ahmednossierr/Zigbee-Transmitter/Scripts/Our_scripts/imag_test.txt

000000
111111
111011
000000
010000
001010
101101
100011
111101
011010
011011
000011
101000
100001
110000
001001
011011
011110
010010
000000
101110
100011
100001
100101
101110
111000
000010
001011
010001
010110
011001
011010
011000
010100
001110
001000
000011
000000
000000
000000
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
