ahmednossierr/Zigbee-Transmitter/ITI_project2026.pdf

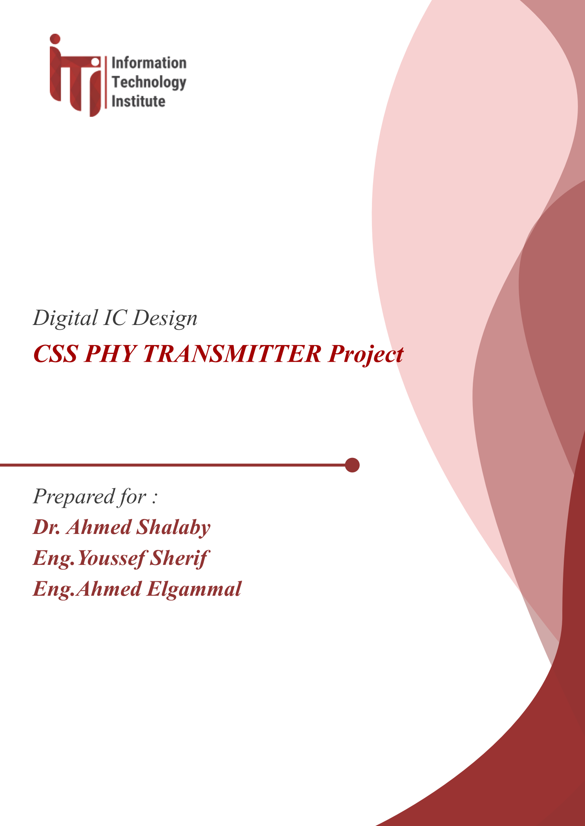
[picture p1: figure]
Digital IC Design; CSS PHY TRANSMITTER Project; Prepared for :; Dr. Ahmed Shalaby; Eng.Youssef Sherif; Eng.Ahmed Elgammal

Digital IC Design CSS_PHY_TRANSMITTER Project – Report

2

## Table of Contents

3

4

## Abstract

This project presents the design and RTL implementation of an IEEE 802.15.4 Chirp Spread Spectrum (CSS) Physical Layer transmitter. The transmitter receives a payload from the MAC layer and processes it through the required PHY operations, including zero padding, I/Q demultiplexing, symbol mapping, QPSK mapping, DQPSK coding, and CSS chirp generation. The design is implemented using Verilog HDL and verified through simulation using ModelSim. The objective is to develop a modular digital transmitter architecture that follows the processing requirements of the CSS PHY.

5

## Chapter1 – Introduction

## 1.1 Motivation

Low-rate wireless personal area networks (LR-WPANs) require low cost, low power, and long battery life. IEEE 802.15.4 defines the MAC and PHY layers for this purpose, including the Chirp Spread Spectrum (CSS) PHY at 2450 MHz. CSS offers strong robustness to multipath fading and interference, and supports longer range and mobility compared to the standard's O-QPSK PHY, but it is significantly more complex to implement in hardware due to its chirp-based modulation and differential coding.

## 1.2 Problem Statement and Objectives

A floating-point MATLAB model of the CSS PHY transmitter already existed, implementing the processing chain defined in the standard. This work converts that model into working hardware: a fixed-point representation is derived, a Verilog RTL implementation is designed module by module, the RTL is verified against the MATLAB model at both unit and integration level, and the design is implemented and verified on a Xilinx Spartan-3A FPGA.

## 1.3 Scope

This work covers the CSS PHY transmitter only; the receiver and MAC integration are left as future work. The existing MATLAB model is used solely as a verification reference, not developed as part of this work.

## 1.4 GitHub Link (https://github.com/ahmednossierr/Zigbee-Transmitter)

That GitHub Link have all the codes and testbenches and constraints files needed for this Zigbee transmitter project.

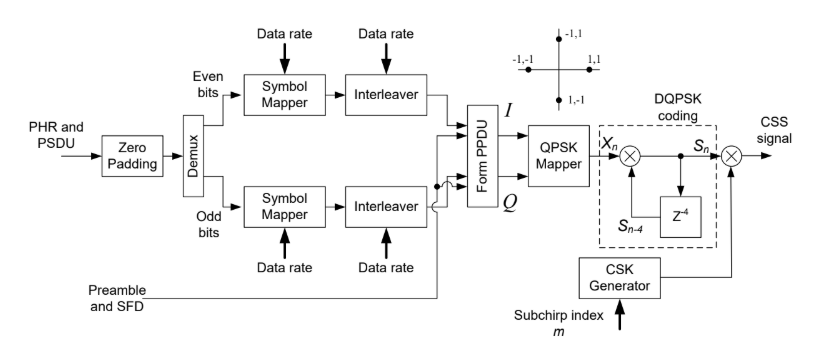
[picture p2: figure]

6

## Chapter 2 —System Architecture & Technical Specifications

## 2.1 IEEE 802.15.4 CSS PPDU Frame Structure

The Physical Protocol Data Unit (PPDU) for the IEEE 802.15.4 Chirp Spread Spectrum (CSS) physical layer consists of three main components: the Synchronization Header (SHR), the PHY Header (PHR), and the PHY Service Data Unit (PSDU) payload.
1. Synchronization Header (SHR): Contains the Preamble sequence and the Start-of-Frame Delimiter (SFD). These allow the receiver to perform bit sync, frame boundary detection, and channel estimation.
2.PHY Header (PHR): Encodes critical packet parameters, including the total length of the payload in bytes (up to 127 bytes).
3.PHY Service Data Unit (PSDU): The actual payload data stream transferred from the MAC layer to the PHY layer.

Figure 1: Format of the CSS PPDU

## 2.2 Transmitter Processing Pipeline

The CSS physical layer transmitter processes the input data bit stream sequentially through multiple digital

Figure 2: Transmitter Pipeline

7

processing blocks before outputting quadrature baseband signal samples.

### 2.2.1 Zero-Padding & Demux (I/Q Splitter)

Zero-Padding: Ensures that the bit stream comprising the PHR and PSDU is padded with trailing zeros so that its total length becomes a integer multiple of N (N = 24 for 250 kbps).
Demux: The serial padded bit stream is split into alternating even bits (in-phase I-channel) and odd bits (quadrature Q-channel).

### 2.2.2 Symbol Mapper (Walsh–Hadamard Encoding)

To enhance immunity against noise and interference, incoming groups of n bits are block-encoded into m-bit orthogonal Walsh–Hadamard codewords using predefined standard look-up tables (Tables 26a/26b of the IEEE 802.15.4 standard). .
For 250 kbps operation, n = 6 input bits map to m = 32 codeword bits.

### 2.2.3 Interleaver

Operating exclusively in 250 kbps mode , the interleaver permutes groups of encoded bits to disperse burst errors. It reorders 16 groups of 4 bits each according to a fixed permutation matrix.

### 2.2.4 PPDU Framer & Controller

The controller coordinates the sequential assembly of the PPDU frame.
It inserts the static preamble and SFD patterns ahead of the PHR and encoded payload data streams before passing them down the datapath.

### 2.2.5 QPSK Mapper & Differential QPSK (DQPSK) Encoder

QPSK Mapper: Grouped pairs of (I,Q) bits are mapped onto standard QPSK constellation points.

DQPSK Encoder: To provide non-coherent phase modulation, each QPSK symbol is differentially encoded across 4 symbol periods:
Sn = Xn ⋅ Sn−4
where Sn represents the complex differential symbol, Xn is the current QPSK symbol, and S0 = S1 = S2 = S3 = exp(jπ/4) serve as the initialization vector.

### 2.2.6 Chirp Spread Keying (CSK) Generator & Modulator

The primary DSP element of the transmitter: four successive DQPSK symbols select one of four possible 152-sample Chirp Sequences (m ∈ {1,2,3,4}).
Each chirp sequence is constructed from four 38-sample sinusoidal subchirps at a sampling frequency fs = 32 MHz, shaped by a raised-cosine window (roll-off factor α = 0.25).
The complex product of the DQPSK symbol sequence and the baseband Chirp Sequence yields the final complex output samples.

8

## 2.3 System Interface & Pinout Description

The top-level synthesizable Verilog module exposes a standardized interface designed for seamless integration with a MAC controller and system memory.

Signal name | Bit width | Direction | Type
clk | 1 | Input | Clock
reset | 1 | Input | Reset
Start_Tx | 1 | Input | Control
payloadlength | 8 | Input | Data
Payload_din | 8 | Input | Data
Payload_addr | 7 | Input | Address
done_tx | 1 | Output | Control
Tx_real | 8 | Output | Data
Tx_imag | 8 | Output | data

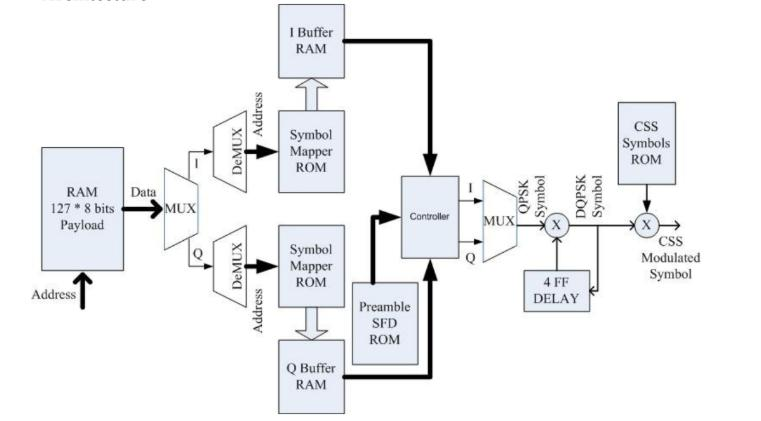
[picture p3: figure]

9

## Chapter 3: Verilog Hardware Design & Implementation

## 3.1 Top-Level Architecture & Datapath Strategy

The CSS PHY transmitter is implemented using a modular top-down architecture, separating control and datapath logic. The top-level module (css_phy_tx) orchestrates the pipeline stages through a centralized Finite State Machine (FSM), controlling signal flow from the initial payload configuration to the final baseband sample output.

## 3.2 Sub-Module Microarchitecture & Signal Interfaces

3.2.1 Payload RAM (ram.v) (https://drive.google.com/file/d/1fCMLNvzGDd0mUedqAVc2X7HKAnIe1TxN/view?usp=drive_link)

Microarchitecture & Logic: Implements a single-clock dual-port RAM storing up to 127 bytes (127 × 8 bits) of incoming MAC payload data. Data is written via din on assertion of write_enable and read out through dout. A generate block continuously exposes the internal memory array as a concatenated 1016-bit vector (psdu_out) to facilitate parallel frame assembly downstream.

Signal Name | Bit Width | Direction | Type | Description
clk | 1 | Input | Clock | System clock signal.
reset | 1 | Input | Reset | Synchronous reset signal.
write_enable | 1 | Input | Control | Write enable strobe for loading payload bytes.
read_enable | 1 | Input | Control | Read enable strobe for reading byte output.

Figure 3: Transmitter Architecture

10

Signal Name | Bit Width | Direction | Type | Description
addr | 7 | Input | Address | RAM byte address pointer (0 to 126).
din | 8 | Input | Data | Input data byte bus.
dout | 8 | Output | Data | Registered output data byte bus.
psdu_out | 1016 | Output | Data | Parallel 1016-bit concatenated payload bitstream bus.

3.2.2 Zero-Padding Unit (zero_padding.v) (https://drive.google.com/file/d/1PPshwE1iD-Davc_w41ABcBWzSWLXKv-_/view?usp=sharing)

Microarchitecture & Logic: Prepends the 12-bit PHY Header (PHR) constructed from payload_length ahead of PSDU. It calculates required trailing zero-padding bits dynamically based on configured Data_Rate (250 kbps) to ensure total frame length is aligned to N-bit boundaries (N = 24). It outputs the serial frame bit by bit along with a complete padded_data vector.

Signal Name | Bit Width | Direction | Type | Description
clk | 1 | Input | Clock | System clock signal
reset | 1 | Input | Reset | Synchronous reset signal
start_tx | 1 | Input | Control | Frame transmission trigger pulse
payload_length | 8 | Input | Data | Total payload length in bytes
PSDU | 1016 | Input | Data | 1016-bit full payload stream from Payload RAM
out_bit | 1 | Output | Data | Serial output bit stream
valid_out | 1 | Output | Control | Active-high output valid indicator
padding_done | 1 | Output | Control | Pulses high when total frame construction completes
padded_data | 1032 | Output | Data | Complete framed and zero-padded bitstream array
total_bits | 11 | Output | Data | Calculated bit length of framed packet

11

### 3.2.3 Demultiplexer Unit (demux.v)

Microarchitecture & Logic: Splits the continuous padded_data stream into parallel in-phase (in_phase, even bits) and quadrature (quadrature, odd bits) streams. A running control flag tracks processing state and increments bit indices by 2 each clock cycle until total_bits - 2 is reached.

Signal Name | Bit Width | Direction | Type | Description
clk | 1 | Input | Clock | System clock signal
reset | 1 | Input | Reset | Synchronous reset signal
start_demux | 1 | Input | Control | Demux processing trigger pulse
padded_data | 1032 | Input | Data | Zero-padded input frame array
total_bits | 11 | Input | Data | Total bit count of frame
in_phase | 1 | Output | Data | Even-indexed bit stream (I-path)
quadrature | 1 | Output | Data | Odd-indexed bit stream (Q-path)
valid_out | 1 | Output | Control | High when output I/Q bits are valid

### 3.2.4 Symbol Mapper (symbol_mapper.v)

Microarchitecture & Logic: Stores the normative IEEE 802.15.4 Walsh–Hadamard orthogonal code table inside a 64-entry 32-bit ROM lookup array . Maps 6-bit incoming symbol indices (data_in) to corresponding 32-bit orthogonal codewords (data_out) with a 1-cycle registered latency.

Signal Name | Bit Width | Direction | Type | Description
clk | 1 | Input | Clock | System clock signal
reset | 1 | Input | Reset | Synchronous reset signal
valid_in | 1 | Input | Control | Active-high input valid strobe
data_in | 6 | Input | Data | 6-bit input symbol vector
data_out | 32 | Output | Data | 32-bit mapped Walsh–Hadamard codeword
valid_out | 1 | Output | Control | Synchronized output valid indicator

12

### 3.2.5 Symbol Buffer (symbol_buffer.v)

Microarchitecture & Logic: Pairs and concatenates successive 32-bit codewords into 64-bit blocks[ci. Uses an internal toggling flag to register the first (even) 32-bit codeword and combine it with the second (odd) incoming 32-bit codeword to drive intrlv_data alongside an intrlv_valid.

Signal Name | Bit Width | Direction | Type | Description
clk | 1 | Input | Clock | System clock signal
reset | 1 | Input | Reset | Synchronous reset signal
sym_valid | 1 | Input | Control | Valid pulse from Symbol Mapper
sym_data | 32 | Input | Data | 32-bit codeword from Symbol Mapper
intrlv_valid | 1 | Output | Control | High when concatenated 64-bit block is ready
intrlv_data | 64 | Output | Data | 64-bit concatenated output block

### 3.2.6 Interleaver Unit (interleaver.v)

Microarchitecture & Logic: Implements the static 250 kbps permutation matrix using a fully combinational Verilog generate loop. Reorders 16 4-bit nibble groups of the incoming 64-bit block (block_in) to yield the permuted output block (block_out) with zero clock delay.

Signal Name | Bit Width | Direction | Type | Description
block_in | 64 | Input | Data | Un-interleaved 64-bit input block
block_out | 64 | Output | Data | Permuted 64-bit output block

### 3.2.7 PPDU Framer & Controller (PPDU.v)

Microarchitecture & Logic: Coordinates PPDU assembly using an internal state machine (IDLE, PREAMBLE, SFD, WAIT, SEND, DONE_STATETransmits an 80-symbol Preamble and 16-symbol SFD pattern from ROM before reading symbol blocks out of an integrated 8-entry 64-bit FIFO (fifo_i, fifo_q) and shifting them out bit by bit.

13

Signal Name | Bit Width | Direction | Type | Description
clk | 1 | Input | Clock | System clock signal
reset | 1 | Input | Reset | Synchronous system reset
start | 1 | Input | Control | Transmission trigger signal
total_bits | 11 | Input | Data | Frame length parameter from Zero-Padding unit
i_path_data | 64 | Input | Data | In-phase 64-bit data block
q_path_data | 64 | Input | Data | Quadrature 64-bit data block
i_path_valid | 1 | Input | Control | Valid indicator for I-path input
q_path_valid | 1 | Input | Control | Valid indicator for Q-path input
ppdu_i_out | 1 | Output | Data | Serial I-path PPDU bit stream
ppdu_q_out | 1 | Output | Data | Serial Q-path PPDU bit stream
ppdu_valid | 1 | Output | Control | High during valid frame bit streaming
done | 1 | Output | Control | Pulse high on packet completion

### 3.2.8 QPSK Mapper (qpsk_mapper.v)

- Microarchitecture & Logic: Maps 2-bit (I,Q) pairs to signed fixed-point QPSK constellation coordinates.Maps input bits {inphase, quadrature} to signed values Xn ∈ {−1,0,1} represented in 2'sd format.
Signal Name | Bit Width | Direction | Type | Description
clk | 1 | Input | Clock | System clock signal[cite: 6].
reset | 1 | Input | Reset | Synchronous reset signal[cite: 6].
inphase | 1 | Input | Data | Incoming I-channel bit[cite: 6].
quadrature | 1 | Input | Data | Incoming Q-channel bit[cite: 6].
valid_in | 1 | Input | Control | Valid signal from PPDU Framer[cite: 6].

14

### 3.2.9 Differential QPSK (DQPSK) Encoder (dqpsk.v)

Microarchitecture & Logic: Converts input rectangular QPSK symbols into 8-phase values (in_phase ∈ {0,2,4,6} representing multiples of 45∘
). Executes complex differential multiplication via phase addition modulo 8 over 4 circulating feedback lanes (mem[0:3]). Initializes phase memories to exp(jπ/4) (phase index 1) upon assertion of reset or pkt_start.
Signal Name | Bit Width | Direction | Type | Description
clk | 1 | Input | Clock | System clock signal[cite: 9].
reset | 1 | Input | Reset | Synchronous reset signal[cite: 9].
pkt_start | 1 | Input | Control | Reload pulse at packet start (resets feedback lanes to 45∘ )[cite: 9].
valid_in | 1 | Input | Control | Valid signal from QPSK mapper[cite: 9].
xn_real | 2 | Input | Data | Signed real QPSK component[cite: 6, 9].
xn_imag | 2 | Input | Data | Signed imaginary QPSK component[cite: 6, 9].
out_valid | 1 | Output | Control | Active-high output valid indicator[cite: 9].
out_phase | 3 | Output | Data | 3-bit phase output index representing 0 ∘

to 315∘
in
| | | | steps of 45∘ [cite: 9].

### 3.2.10 CSK Generator (CSK.v)

- Microarchitecture & Logic: Generates 152-sample Chirp Spread Spectrum baseband waveform sequences.Integrates a 8-bit timer module to step through ROM addresses (0 to 151) Reads pre-quantized 6-bit signed fixed-point real and imaginary chirp coefficients (real_out, imag_out) stored in
Signal Name | Bit Width | Direction | Type | Description
xn_real | 2 | Output | Data | Signed real QPSK symbol component (Q1.0)[cite: 6].
xn_imag | 2 | Output | Data | Signed imaginary QPSK symbol component (Q1.0)[cite: 6].
valid_out | 1 | Output | Control | Output valid indicator[cite: 6].

15

external lookup text files (chirp_r, chirp_I)

Signal Name | Bit Width | Direction | Type | Description
clk | 1 | Input | Clock | System clock signal
CSK_rst | 1 | Input | Reset | Timer reset signal
real_out | 6 | Output | Data | 6-bit signed fixed-point real output sample (Q1.5)
imag_out | 6 | Output | Data | 6-bit signed fixed-point imaginary output sample (Q1.5)

### 3.2.11 Final Multiplier

Microarchitecture & Logic: This block performs complex multiplication between the differentially encoded QPSK phase symbol Sn and the complex baseband chirp sample provided by the CSK generator.

Let the complex DQPSK symbol be expressed as:
Sn = Re(Sn

) + j Im(Sn

)

The complex baseband output sample is formulated as: Tx_complex = Sn ⋅ (csk_real + j ⋅ csk_imag)

Expanding into real and imaginary components: tx_real = Re(Sn

) ⋅ csk_real − Im(Sn

) ⋅ csk_imag
tx_imag = Re(Sn

) ⋅ csk_imag + Im(Sn

) ⋅ csk_real

Since sn_phase takes discrete phase values restricted to 45∘

, 135∘

, 225∘

, and 315∘
(corresponding to Sn ∈
{±1 ± j1}), the hardware optimization eliminates full multipliers. Instead, it evaluates sn_phase via a conditional routing multiplexer structure (signed additions/subtractions):
sn_phase (3-bit) | Phase Angle | Equivalent Sn | Real Output (tx_real) | Imaginary Output (tx_imag)
3’d1 | 45° | +1+j1 | csk_real -csk_imag | csk_real + csk_imag
3’d3 | 135° | -1+j1 | -csk_real - csk_imag | csk_real - csk_imag
3’d5 | 225° | -1-j1 | csk_imag - csk_real | -csk_real - csk_imag
3’d7 | 315° | +1-j1 | csk_real + csk_imag | csk_imag - csk_real

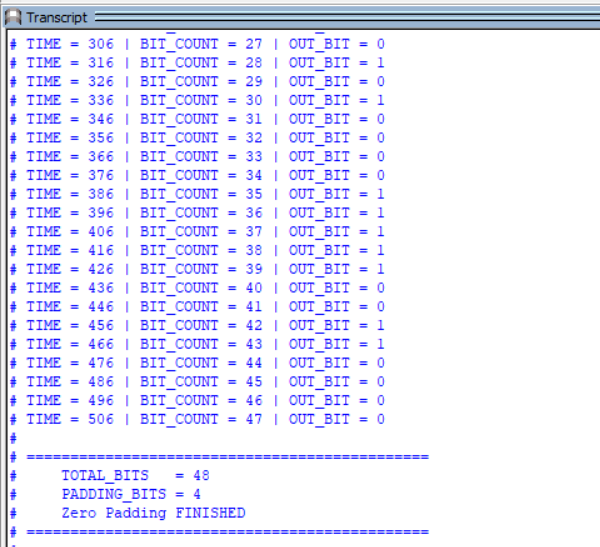
[picture p4: figure]
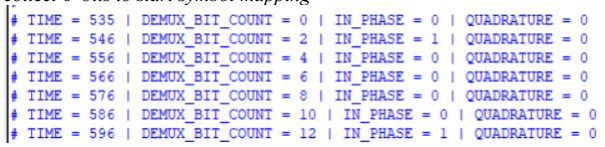
[picture p5: figure]
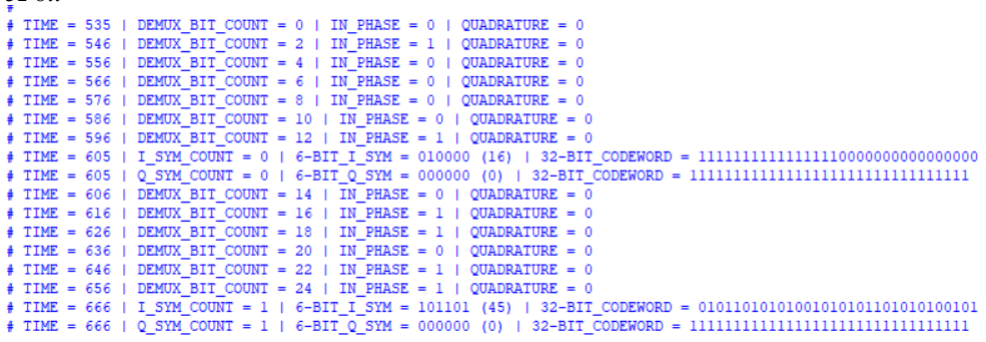
[picture p6: figure]

16

## Chapter 5: Simulation, Functional Verification & Results

## 5.1 Verification using QuestaSim

Using payload length = 4 , for simplicity for debugging at first
- Zero padding check : sending data serial bit by bit every clock cycle

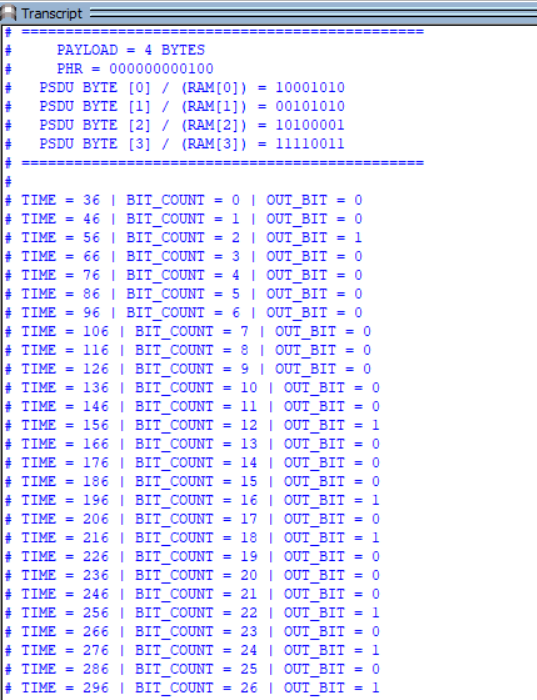
[picture p7: figure]

- Demux check : Even bits goes to Inphase path and odd bits goes to Quadrature path until every path collect 6 bits to start symbol mapping
- Symbol mapper check : When collected 6 bits from demux start to take these 6 bits and mapping it into 32 bit
- Interleaver check : After collecting 32 bit from symbol mapper wait again till collecting another 32 bit to be 64 bit to start interleaver , which divides 64 bits into 16 group with each group containing 4 bits

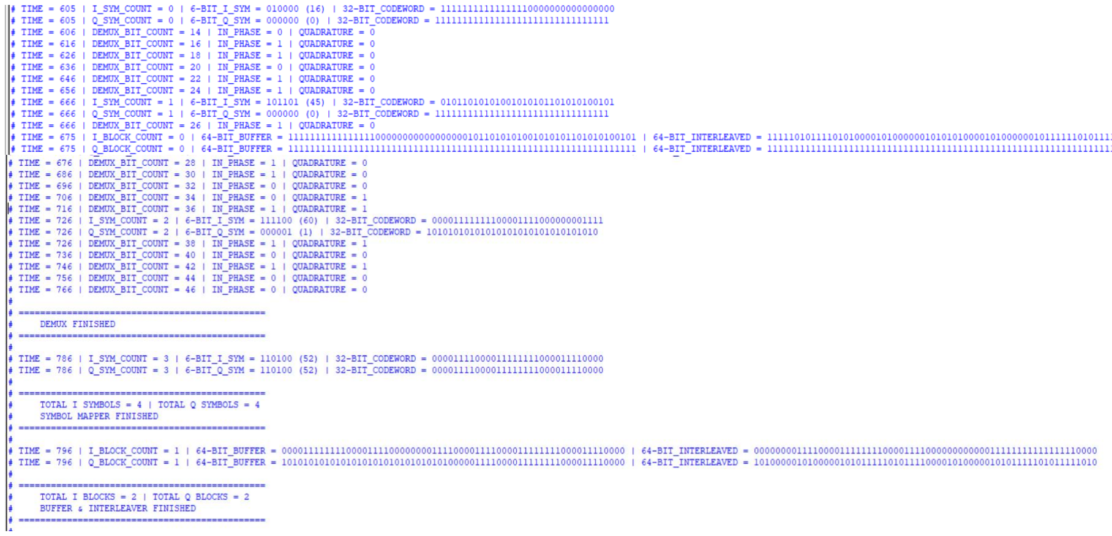
[picture p8: figure]

17

Now we start to send every bit by bit to PPDU → QPSK →DQPSK*CSK→CSS Signal
- PPDU check : Verify that the PPDU Framer correctly assembles and transmits the complete frame by serializing the Preamble, SFD, PHR, and PSDU data on the I and Q paths. For 250 kbps,
Preamble = 80 bits (all ones), SFD = 16 bits, PHR = 12 bits, and PSDU = 8×payloadLength. For this test case, payloadLength = 4, so PHR+PSDU = 12 + (8×4) = 44 bits, which Zero Padding rounds up to the next multiple of N=24, giving 48 bits total. Demux splits this into 24 bits per path (I and Q), and the Symbol Mapper block-codes each path at rate 6→32 (each 6-bit input symbol becomes a 32-bit) expanding 24 bits into 4 codewords × 32 bits = 128 bits per path. gives the final chip count per path: 80 (Preamble) + 16 (SFD) + 128 (coded PHR+PSDU) = 224 chips .
- QPSK Mapper check : Verify that the QPSK Mapper correctly converts each (I,Q)chip pair from the PPDU into one complex QPSK symbol Xnaccording to

Xn =

(I + Q) − j(I − Q)
2

The four input combinations are mapped as
{I,Q} = {0,0} | Xn = −1 + 0J
{I,Q} = {0,1} | Xn = 0 + 1J
{I,Q} = {1,0} | Xn = 0 − 1J
{I,Q} = {1,1} | Xn = 1 + 0J
- DQPSK check: Verify that the DQPSK Encoder generates Snusing the current QPSK symbol Xnand the symbol delayed by four positions:
Sn = Xn ⋅ Sn−4
- The first four symbols are initialized at 45∘
. The output phase is checked to ensure that Snalways has one of the four expected phases: 45°, 135°, 225°, or 315° throughout the transmission.
- CSK check : Verify that the CSK Generator correctly generates the real and imaginary chirp samples from the ROM. The output samples are checked against the reference CSK values for the complete

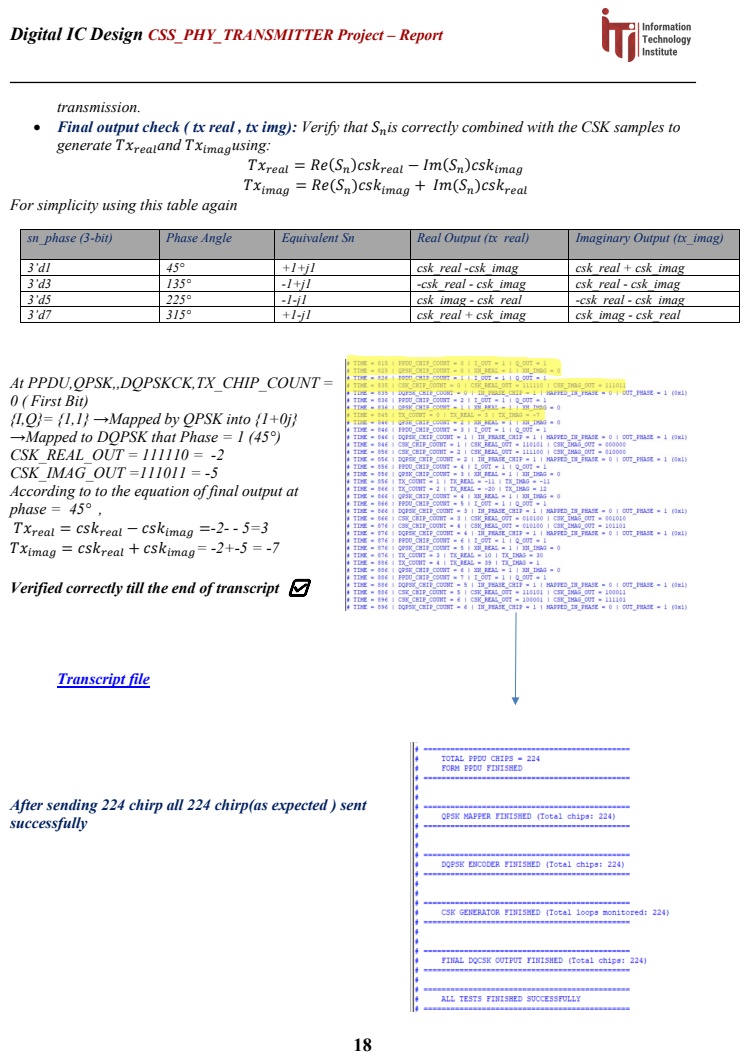
[picture p9: page 18]
)cskimag; )cskreal; Transcript file

transmission.
• Final output check ( tx real , tx img): Verify that Snis correctly combined with the CSK samples to
generate Txrealand Tximagusing:

Txreal = Re(Sn
Tximag = Re(Sn

)cskreal − Im(Sn
)cskimag + Im(Sn

For simplicity using this table again

sn_phase (3-bit) | Phase Angle | Equivalent Sn | Real Output (tx_real) | Imaginary Output (tx_imag)

3’d1 | 45° | +1+j1 | csk_real -csk_imag | csk_real + csk_imag
3’d3 | 135° | -1+j1 | -csk_real - csk_imag | csk_real - csk_imag
3’d5 | 225° | -1-j1 | csk_imag - csk_real | -csk_real - csk_imag
3’d7 | 315° | +1-j1 | csk_real + csk_imag | csk_imag - csk_real

At PPDU,QPSK,,DQPSKCK,TX_CHIP_COUNT =
0 ( First Bit)
{I,Q}= {1,1} →Mapped by QPSK into {1+0j}
→Mapped to DQPSK that Phase = 1 (45°)
CSK_REAL_OUT = 111110 = -2
CSK_IMAG_OUT =111011 = -5
According to to the equation of final output at
phase = 45° ,
Txreal = cskreal − cskimag =-2- - 5=3
Tximag = cskreal + cskimag= -2+-5 = -7

Verified correctly till the end of transcript ✅

After sending 224 chirp all 224 chirp(as expected ) sent
successfully

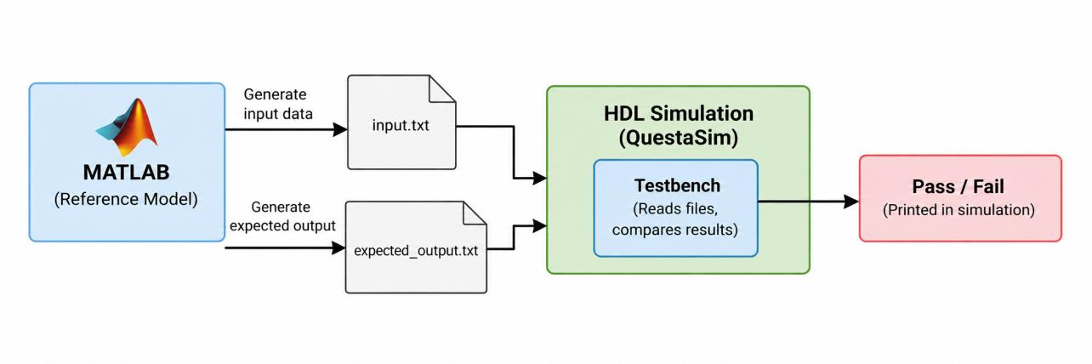
[picture p10: figure]

19

## 5.2 Verification using MATLAB

### 5.2.1 Methodology

The verification process starts with MATLAB, which acts as the reference model. MATLAB generates both the input test data and the expected output, saving them in separate .txt files. These files are then provided to the HDL design running in QuestaSim. During simulation, the testbench reads the input data and expected output directly from the files, applies the inputs to the design, and compares the generated HDL results with the MATLAB reference results. If all outputs match the expected values, the testbench reports PASS; otherwise, it reports FAIL. This process ensures that the HDL implementation behaves correctly and matches the MATLAB reference model.

### 5.2.2 Modification on MATLAB Files

- Modifications Made to the MATLAB Files
To prepare the MATLAB reference model for hardware implementation, the chirp sequence was converted from floating-point to a fixed-point representation compatible with the RTL design.
- Chirp Sequence Quantization
The chirp waveform is initially generated using complex exponential functions, producing floating-point values. These samples were quantized in runMe.m using the selected DAC resolution:
chirpSequence_Tx = floor(chirpSequence *(2^(TxDACbitNumber-1)-1));
With TxDACbitNumber = 6, the samples are scaled and truncated to integer values.
- Fixed-Point Representation
The quantized real and imaginary components were converted into MATLAB fixed-point objects using a signed 6-bit format with zero fractional bits:
re = fi(chirpSequenceReal_tofile, 1, 6, 0);
im = fi(chirpSequenceImag_tofile, 1, 6, 0);
The complex chirp sequence was then separated into real and imaginary components and converted into two's-complement binary strings.
- ROM File Generation
Finally, the binary values were written to separate text files:
chirpSequenceReal_tofile.txt
chirpSequenceImag_tofile.txt
These files are used to initialize the corresponding ROMs in the RTL design through $readmemb.

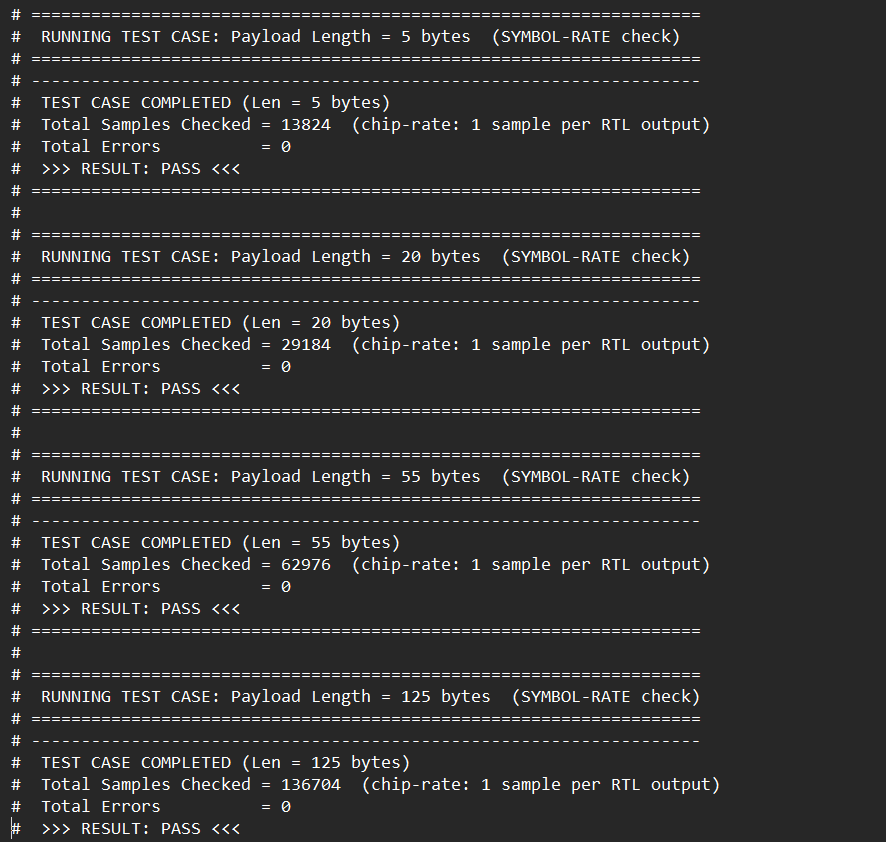
[picture p11: figure]

20

- Summary
The main modification was quantizing the floating-point chirp waveform and converting it into a 6-bit signed fixed-point binary format suitable for hardware implementation.
The selected resolution of R = 6 bits was chosen because it provides sufficient accuracy to meet the required MSE specification while reducing hardware complexity, ROM size, and power consumption compared to using a higher resolution such as R = 8 bits.

### 5.2.3 Verilog TestBench

A self-checking SystemVerilog testbench was developed to verify the CSS PHY transmitter against the MATLAB reference model. MATLAB generates the input payload along with the expected real and imaginary output samples, which are stored in .txt files. During simulation, the testbench loads the input data, applies it to the DUT, and compares the generated transmitter outputs with the corresponding MATLAB reference samples on a sample-by-sample basis. Any mismatch is detected and reported, while a complete match produces a PASS result. The verification is performed for multiple payload sizes to ensure correct operation under different input conditions. The complete RTL design, testbench, and supporting files are available through the GitHub link provided in Section 1.4.

Whole Transcript (https://drive.google.com/file/d/1mXiQUyQ210RPBpkR_wJMaxRR3HESVlGZ/view?usp=drive_link)

## 5.3 FPGA implementation

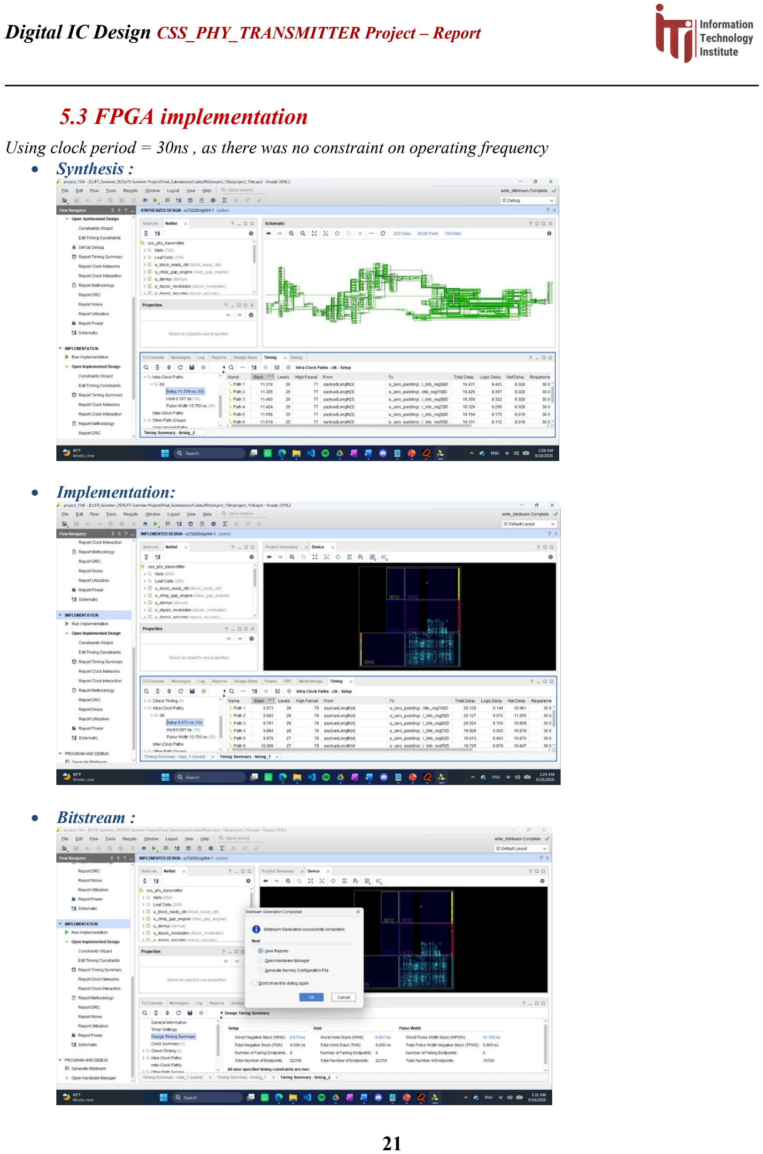
[picture p12: page 21]

21

Using clock period = 30ns , as there was no constraint on operating frequency
- Synthesis :
- Implementation:
- Bitstream :

22

Reports for timing :
- Synthesis (https://drive.google.com/file/d/1ktpVzEUg45-K0OeTKgoamK3Z_-RwvZOC/view?usp=drive_link)
- Implementation (https://drive.google.com/file/d/1mt960Ya_iQD54HszFBseFe40x8WcfqyQ/view?usp=drive_link)

Reports for utilization:
- Synthesis (https://drive.google.com/file/d/1BCNwphsaU2m65P39puto5dtAvx34kwT0/view?usp=drive_link)
- Implementation (https://drive.google.com/file/d/1_6MSW0KT7aEQC1D8Lpm-gtXY3VrT5hUT/view?usp=drive_link)
