ahmednossierr/Zigbee-Transmitter/(commit log)

2026-09-17 Refactor chirp_gap_engine to remove reset sensitivity
    Removed reset condition from clocked always blocks for phase FIFO and chip-rate state machine.
    [chirp_gap_engine.v]
2026-09-17 Delete self-checking task and comments in testbench
    Removed comments and the self-checking task for the test case.
2026-09-18 Fix formatting issues in css_phy_transmitter_tb_M.v
    [css_phy_transmitter_tb_M.v]
2026-09-18 updates
    Removed comments explaining fixes related to fifo_count and visibility issues.
    [PPDU.v]
2026-09-18 Refactor input wire declarations in block_ready_ctrl
